YevheniiM/kvitochka/Schematic.pdf

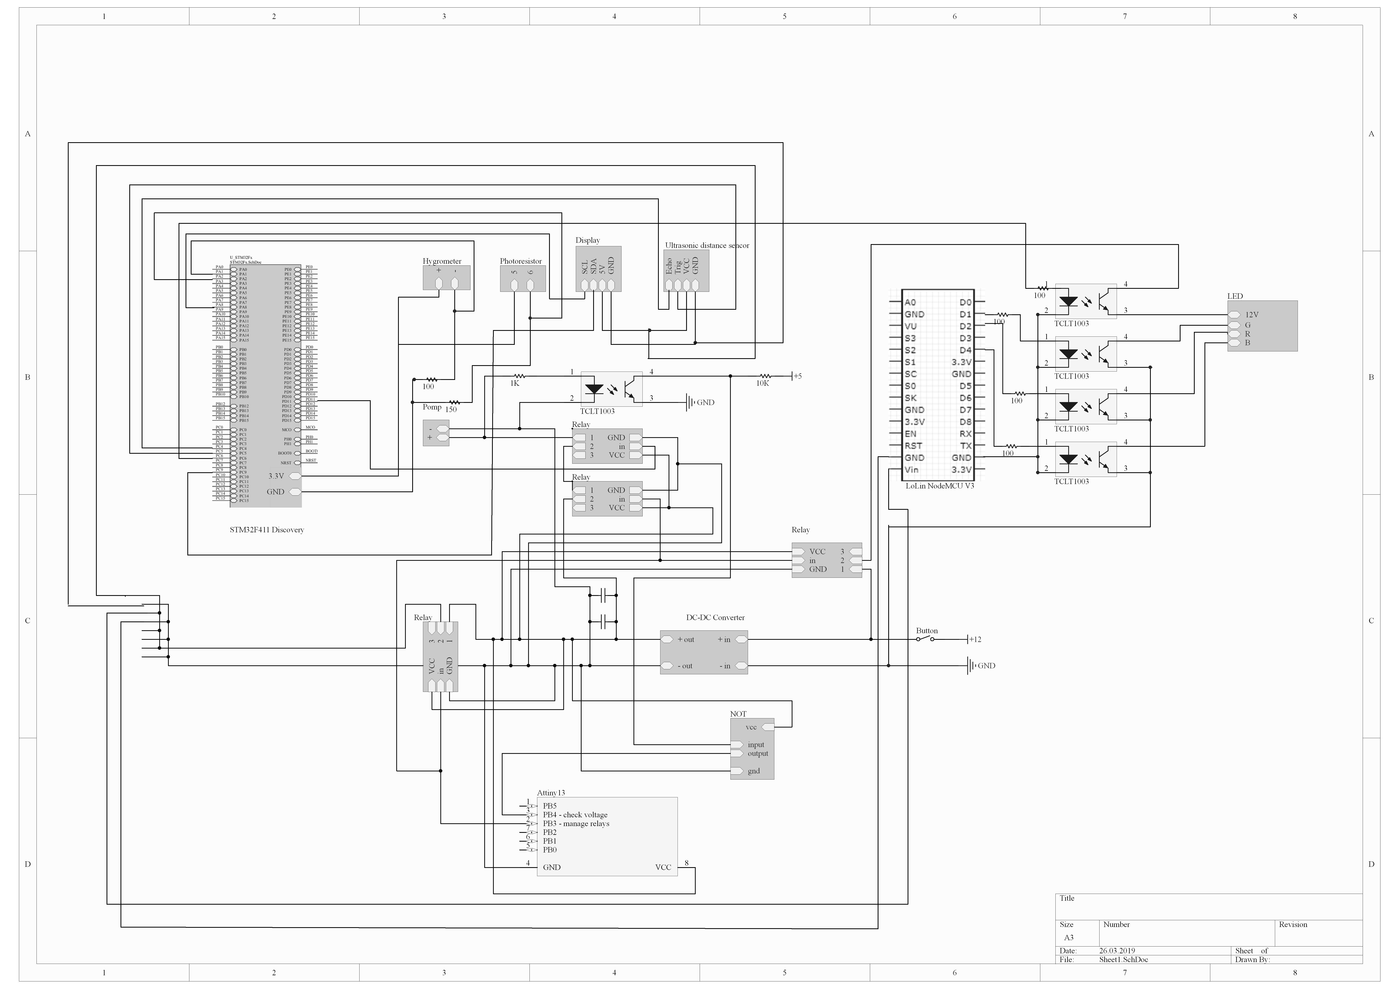
[picture p1: page 1]
