YevheniiM/kvitochka/stm32f411/stm32f411.ioc

Mcu.UserName=STM32F411VETx
PA0-WKUP.Signal=GPXTI0
PA1.GPIO_Label=ADC1_IN1
PA1.Signal=ADCx_IN1
PA10.Signal=USART1_RX
PA11.Signal=GPIO_Analog
PA12.GPIO_Label=OTG_FS_DP
PA12.Signal=USB_OTG_FS_DP
PA13.GPIO_Label=SWDIO
PA13.Signal=SYS_JTMS-SWDIO
PA14.GPIO_Label=SWCLK
PA14.Signal=SYS_JTCK-SWCLK
PA15.Signal=USART1_TX
PA2.GPIO_Label=ADC1_IN2
PA2.Signal=ADCx_IN2
PA4.GPIO_Label=I2S3_WS [CS43L22_LRCK]
PA4.Signal=I2S3_WS
PA5.GPIO_Label=SPI1_SCK [L3GD20_SC/SPC]
PA5.Signal=SPI1_SCK
PA6.GPIO_Label=SPI1_MISO [L3GD20_AS0/SDO]
PA6.Signal=SPI1_MISO
PA7.GPIO_Label=SPI1_MOSI [L3GD20_SDA/SDI/SDO]
PA7.Signal=SPI1_MOSI
PA8.Signal=I2C3_SCL
PA9.GPIO_Label=VBUS_FS
PA9.Signal=USB_OTG_FS_VBUS
PB0.Signal=S_TIM3_CH3
PB1.Signal=S_TIM3_CH4
PB10.GPIO_Label=CLK_IN [MP45DT02_CLK]
PB10.Signal=I2S2_CK
PB12.Signal=I2S2_WS
PB3.GPIO_Label=SWO
PB3.Signal=SYS_JTDO-SWO
PB5.Signal=S_TIM3_CH2
PB6.GPIO_Label=Audio_SCL [CS43L22_SCL]
PB6.Signal=I2C1_SCL
PB9.GPIO_Label=Audio_SDA [CS43L22_SDA]
PB9.Signal=I2C1_SDA
PC0.GPIO_Label=OTG_FS_PowerSwitchOn
PC0.Signal=GPIO_Output
PC10.GPIO_Label=I2S3_SCK [CS43L22_SCLK]
PC10.Signal=I2S3_CK
PC12.GPIO_Label=I2S3_SD [CS43L22_SDIN]
PC12.Signal=I2S3_SD
PC14-OSC32_IN.GPIO_Label=PC14-OSC32_IN
PC14-OSC32_IN.Signal=RCC_OSC32_IN
PC15-OSC32_OUT.GPIO_Label=PC15-OSC32_OUT
PC15-OSC32_OUT.Signal=RCC_OSC32_OUT
PC2.Signal=I2S2_ext_SD
PC3.GPIO_Label=PDM_OUT [MP45DT02_DOUT]
PC3.Signal=I2S2_SD
PC4.GPIO_Label=ECHOI
PC4.Signal=GPXTI4
PC5.GPIO_Label=TRIG
PC5.Signal=GPIO_Output
PC6.Signal=S_TIM3_CH1
PC7.GPIO_Label=I2S3_MCK [CS43L22_MCLK]
PC7.Signal=I2S3_MCK
PC9.Signal=I2C3_SDA
PD10.Signal=GPIO_Output
PD11.Signal=GPIO_Output
PD12.GPIO_Label=LD4 [Green Led]
PD12.Signal=GPIO_Output
PD13.GPIO_Label=LD3 [Orange Led]
PD13.Signal=GPIO_Output
PD14.GPIO_Label=LD5 [Red Led]
PD14.Signal=GPIO_Output
PD15.GPIO_Label=LD6 [Blue Led]
PD15.Signal=GPIO_Output
PD4.GPIO_Label=Audio_RST [CS43L22_RESET]
PD4.Signal=GPIO_Output
PD5.GPIO_Label=OTG_FS_OverCurrent
PD5.Signal=GPIO_Input
PD9.Signal=GPIO_Analog
PE1.GPIO_Label=MEMS_INT2 [L3GD20_INT2]
PE1.Signal=GPXTI1
PE10.GPIO_Label=led_4
PE10.Signal=GPIO_Output
PE11.GPIO_Label=led_5
PE11.Signal=GPIO_Output
PE12.GPIO_Label=led_6
PE12.Signal=GPIO_Output
PE13.GPIO_Label=led_7
PE13.Signal=GPIO_Output
PE14.GPIO_Label=led_8
PE14.Signal=GPIO_Output
PE15.GPIO_Label=led_9
PE15.Signal=GPIO_Output
PE2.GPIO_Label=DATA_Ready [LSM303DLHC_DRDY]
PE2.Signal=GPIO_Input
PE3.GPIO_Label=CS_I2C/SPI [L3GD20_CS_I2C/SPI]
PE3.Signal=GPIO_Output
PE5.GPIO_Label=INT2 [LSM303DLHC_INT2]
PE5.Signal=GPXTI5
PE7.GPIO_Label=led_1
PE7.Signal=GPIO_Output
PE8.GPIO_Label=led_2
PE8.Signal=GPIO_Output
PE9.GPIO_Label=led_3
PE9.Signal=GPIO_Output
