YevheniiM/kvitochka/(commit log)

2019-03-26 we finally did it
    [stm32f411 Run.cfg]
2019-03-27 Schematic added
