YevheniiM/kvitochka/(notices)

Notices in the files:
stm32f411/Src/main.c:
(C) COPYRIGHT STMicroelectronics *****END OF FILE
